ikutakanpani/Ardduino-fader/(list of files, drawings)

Other design files:
基板/pcb_f.pcb
