ikutakanpani/Ardduino-fader/(commit log)

2024-02-06 Update arduino-fader.ino
    コメント追加
2024-02-06 Update PIDControl.h
    変数型修正
